svanessen29/Table-Top-Muon-Tomography/Figures/layout1.jpg

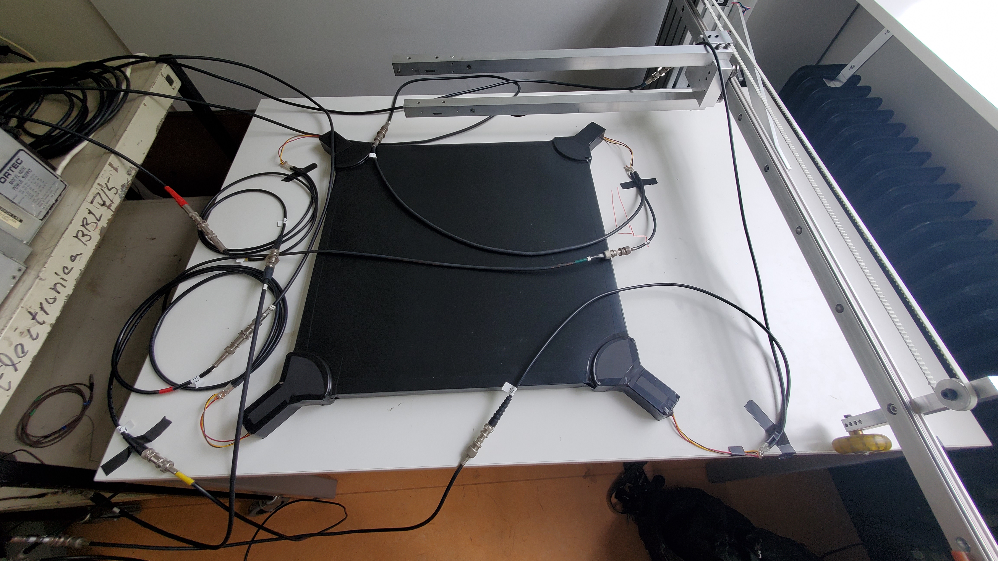
Figures/layout1.jpg
