svanessen29/Table-Top-Muon-Tomography/Figures/layout2.jpg

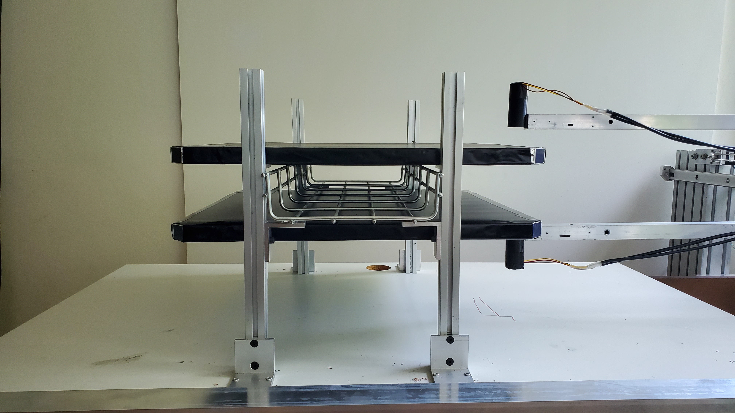
Figures/layout2.jpg
