svanessen29/Table-Top-Muon-Tomography/Software/scintillator_tape_spectra/tape_spectra_T2.png

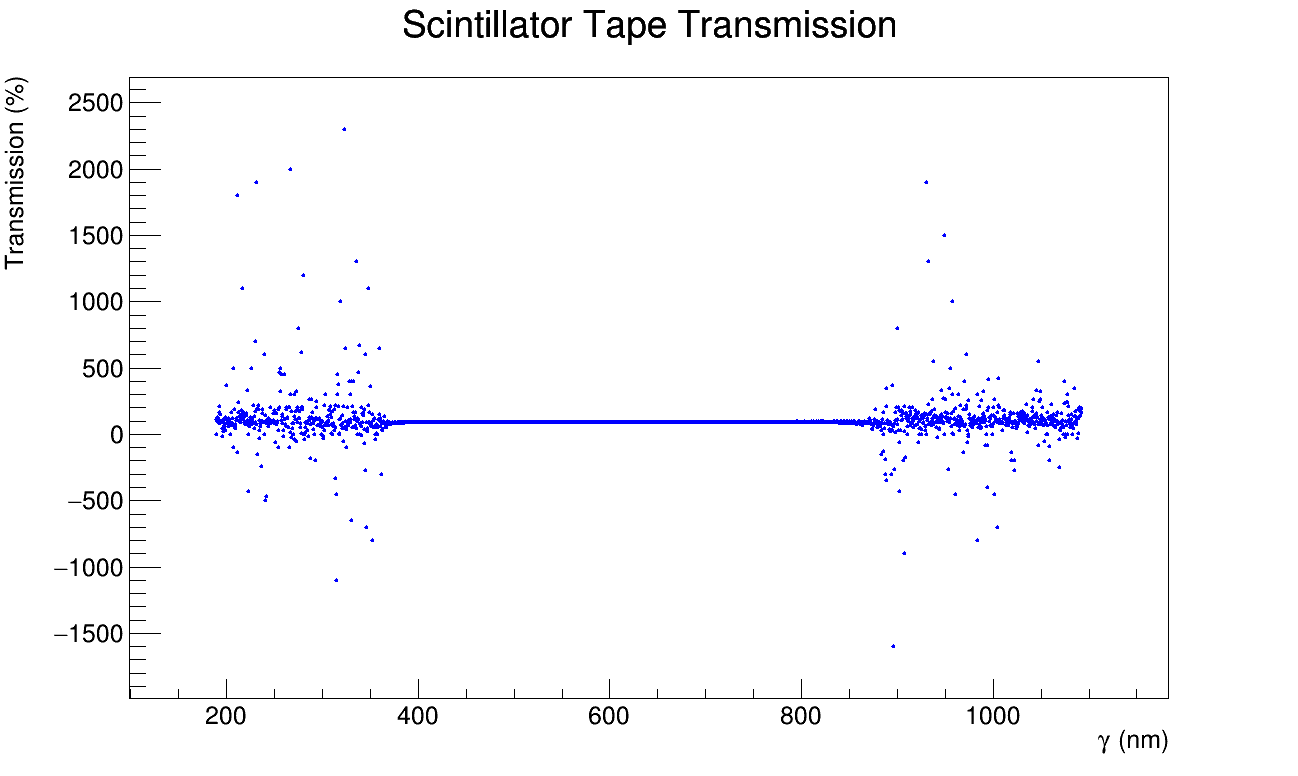
Software/scintillator_tape_spectra/tape_spectra_T2.png
