svanessen29/Table-Top-Muon-Tomography/Documents/BuildInstructions/README.md

# Build Instructions
This sections outlines the steps that were taken to fully construct the table-top muon scanner

## Sections
1. [Frame Assembly](FrameAssembly.md)
2. How to prepare the [scintillator](Scintillator.md)
3. How to prepare the [PMT](PMT.md)
4. How to connect all the [electronics](Electronics.md) together
