svanessen29/Table-Top-Muon-Tomography/Figures/setup_pmt2_a.jpg

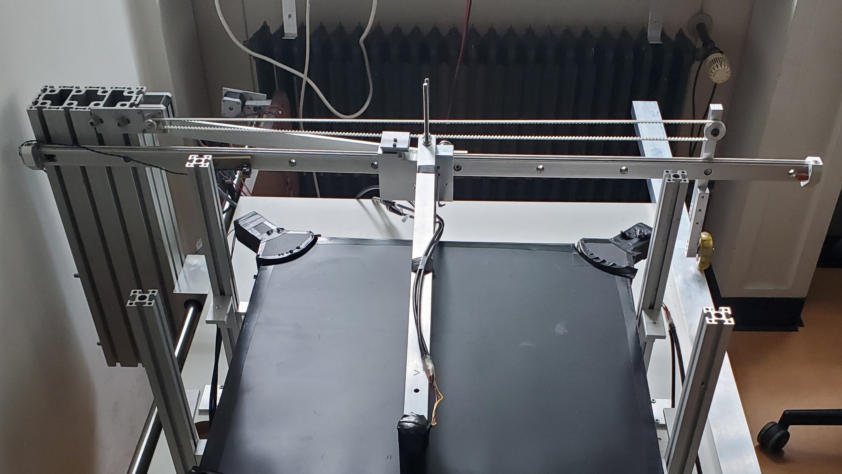
Figures/setup_pmt2_a.jpg
