svanessen29/Table-Top-Muon-Tomography/Figures/setup_pmt8.jpg

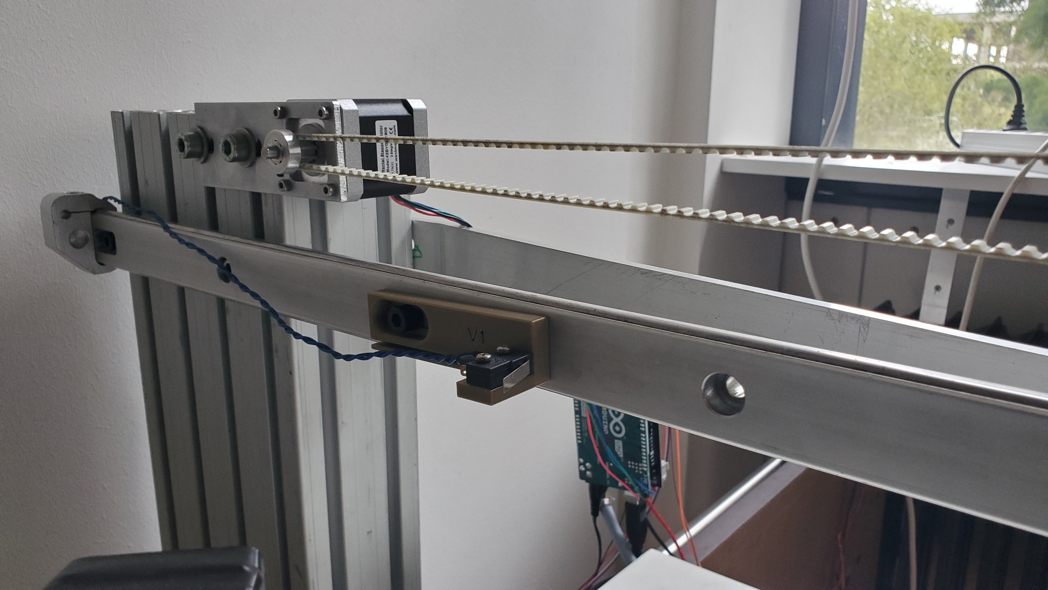
Figures/setup_pmt8.jpg
