svanessen29/Table-Top-Muon-Tomography/Results/PMT_graphs/PMT10_voltage.pdf

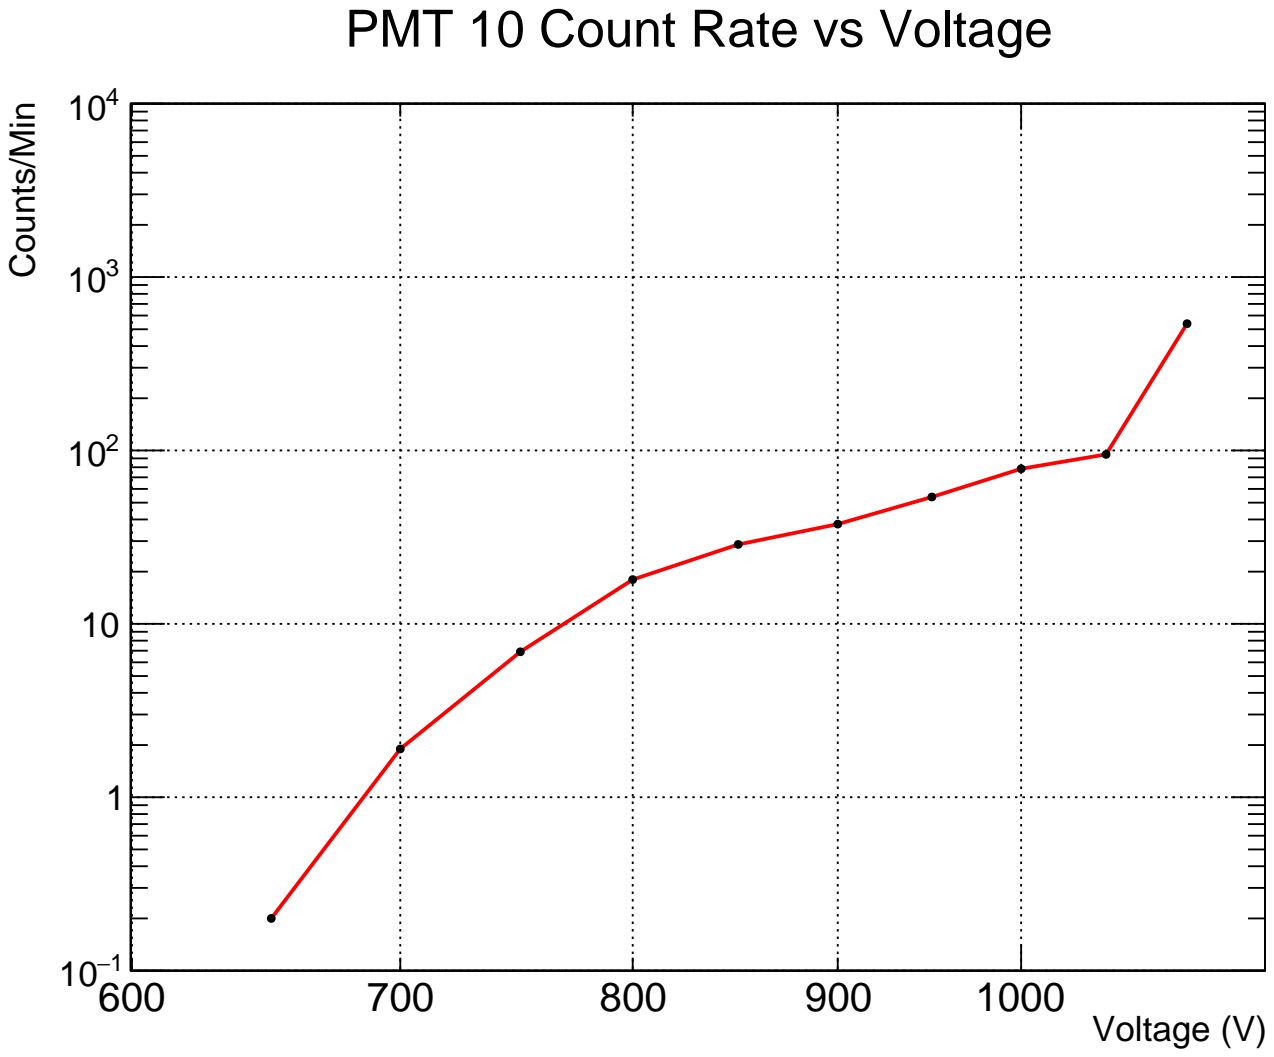
[picture p23: figure]
Voltage (V) ⁻¹ 10; Counts/Min; PMT 10 Count Rate vs Voltage
