svanessen29/Table-Top-Muon-Tomography/Results/PMT_graphs/PMT11_voltage.pdf

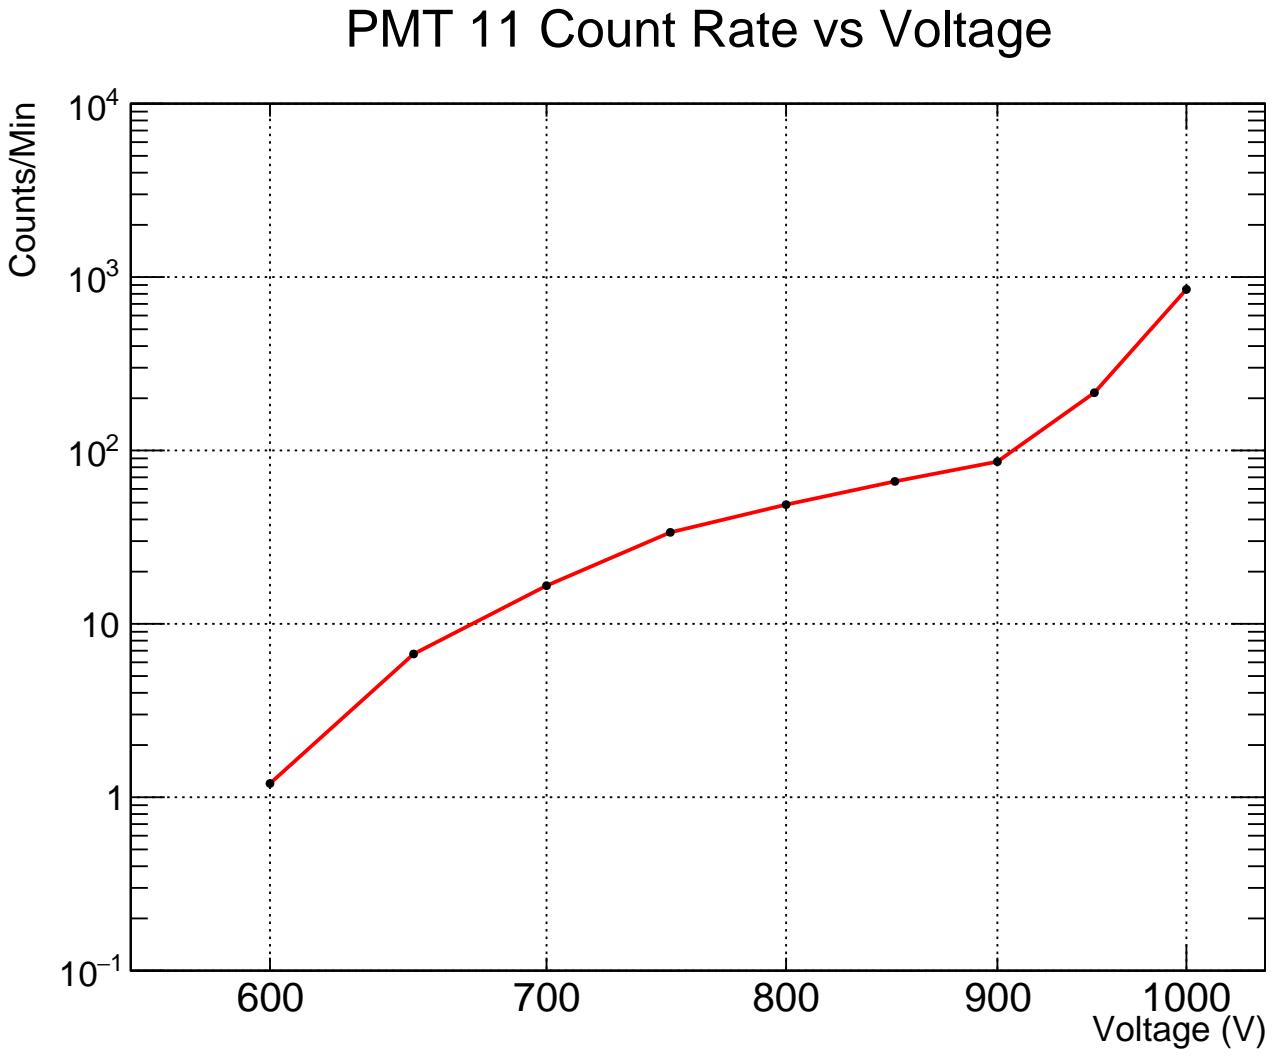
[picture p24: figure]
Voltage (V) ⁻¹ 10; Counts/Min; PMT 11 Count Rate vs Voltage
