svanessen29/Table-Top-Muon-Tomography/Results/PMT_graphs/PMT1_voltage.pdf

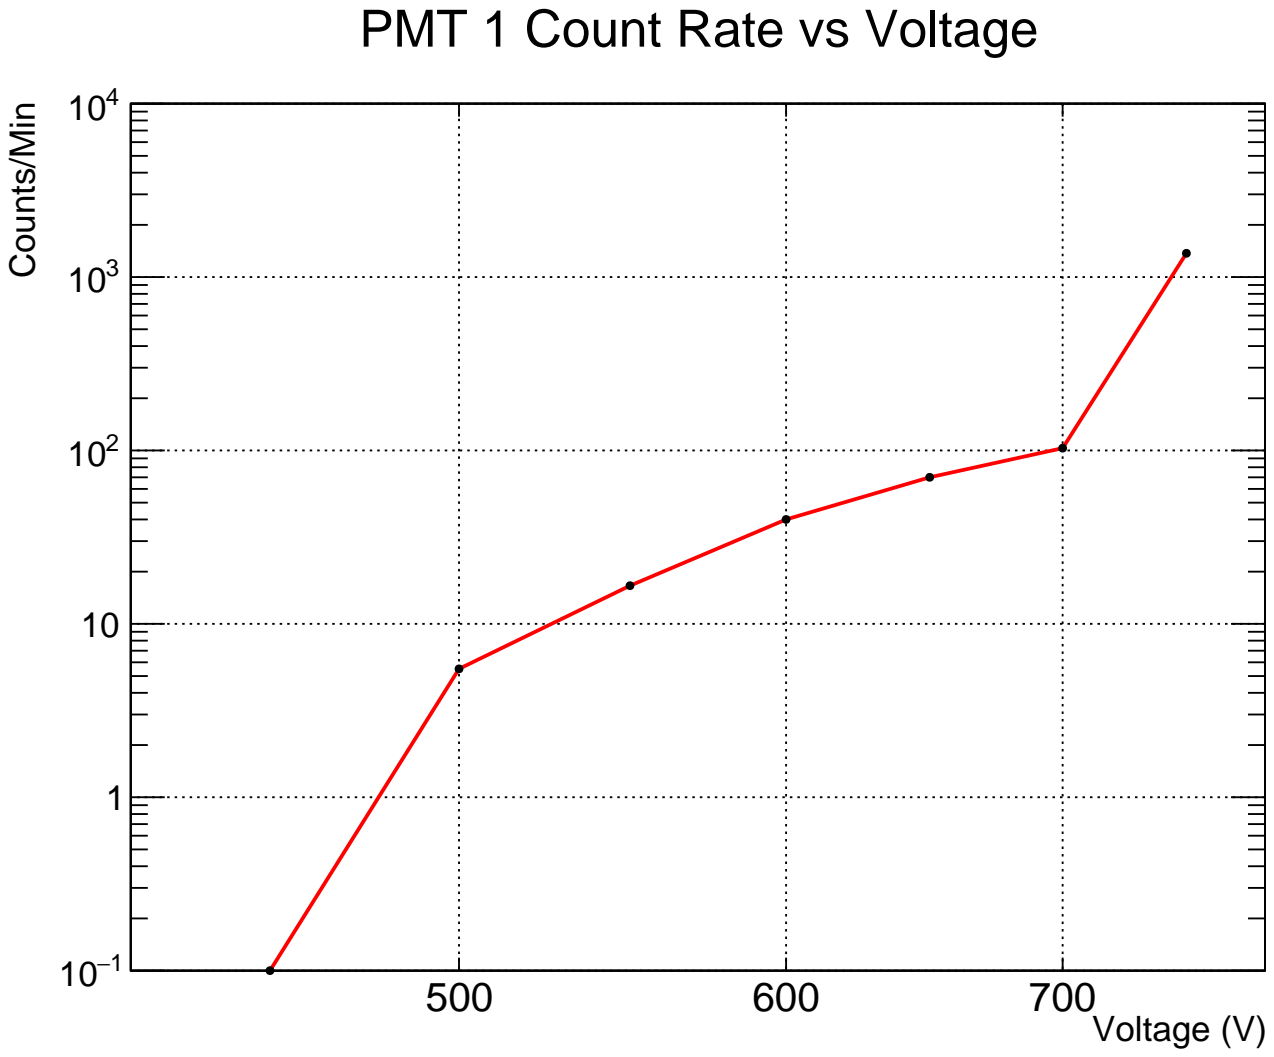
[picture p25: figure]
Voltage (V); Counts/Min; PMT 1 Count Rate vs Voltage
