svanessen29/Table-Top-Muon-Tomography/Results/PMT_graphs/PMT2_voltage.pdf

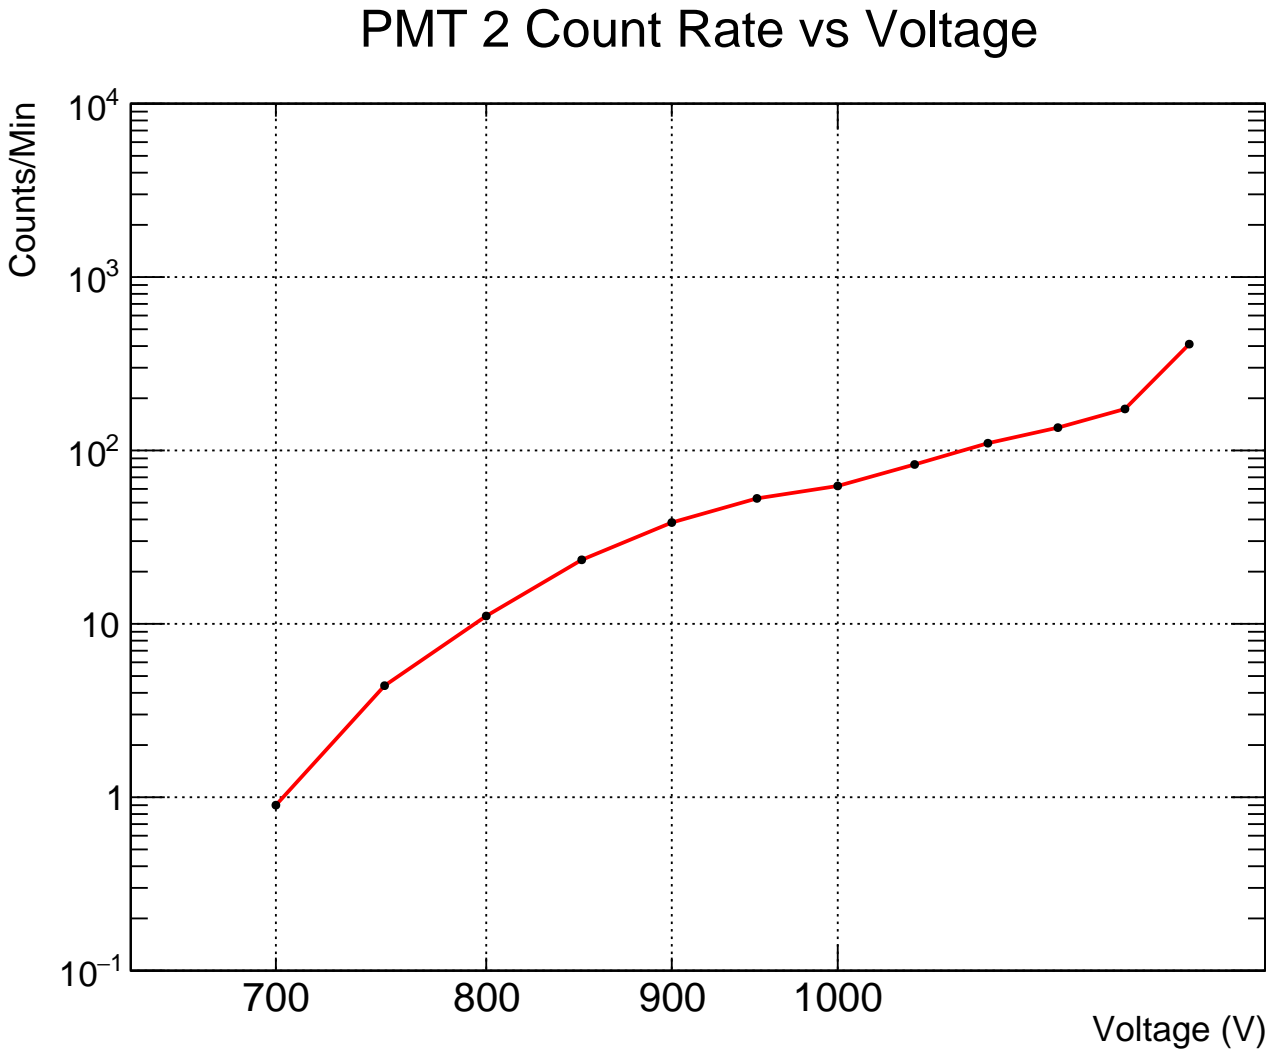
[picture p26: figure]
Voltage (V) ⁻¹ 10; Counts/Min; PMT 2 Count Rate vs Voltage
