svanessen29/Table-Top-Muon-Tomography/Results/PMT_graphs/PMT3_voltage.pdf

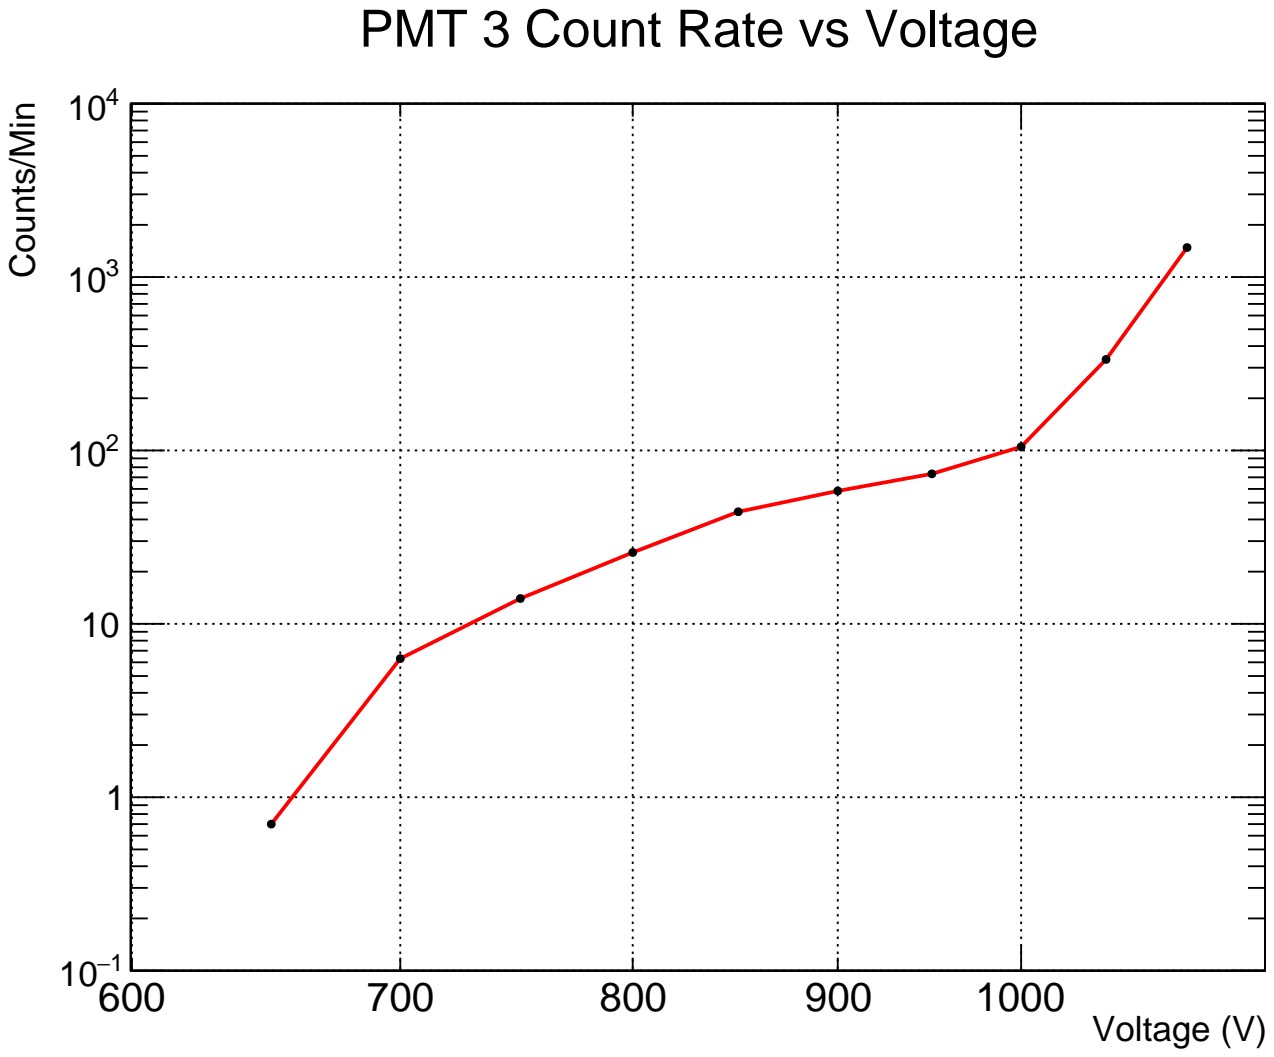
[picture p27: figure]
Voltage (V) ⁻¹ 10; Counts/Min; PMT 3 Count Rate vs Voltage
