svanessen29/Table-Top-Muon-Tomography/Results/PMT_graphs/PMT4_voltage.pdf

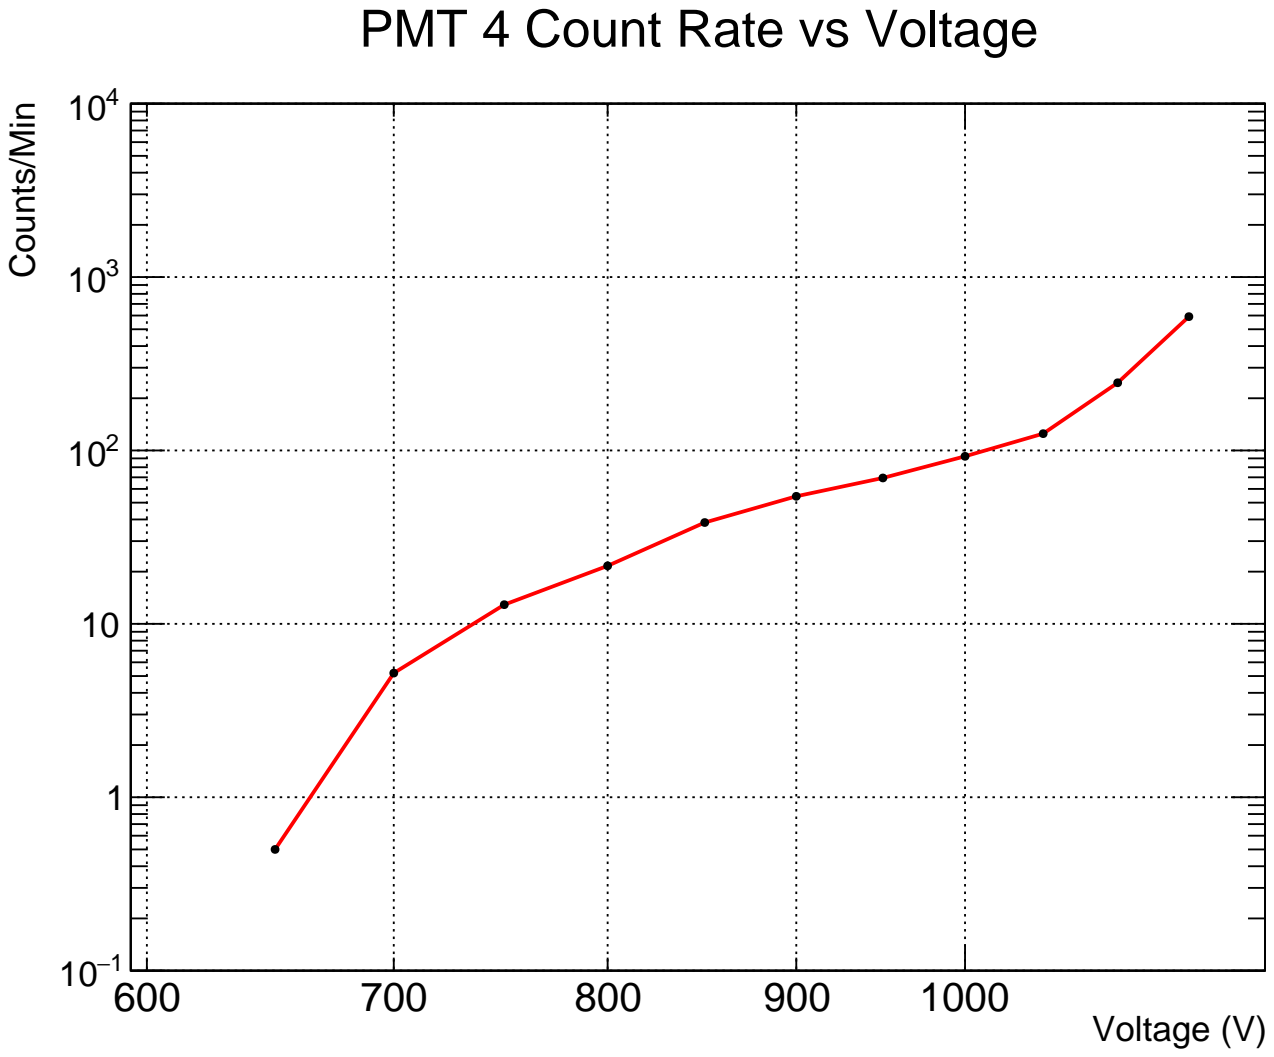
[picture p28: figure]
Voltage (V) ⁻¹ 10; Counts/Min; PMT 4 Count Rate vs Voltage
