svanessen29/Table-Top-Muon-Tomography/Results/PMT_graphs/PMT5_voltage.pdf

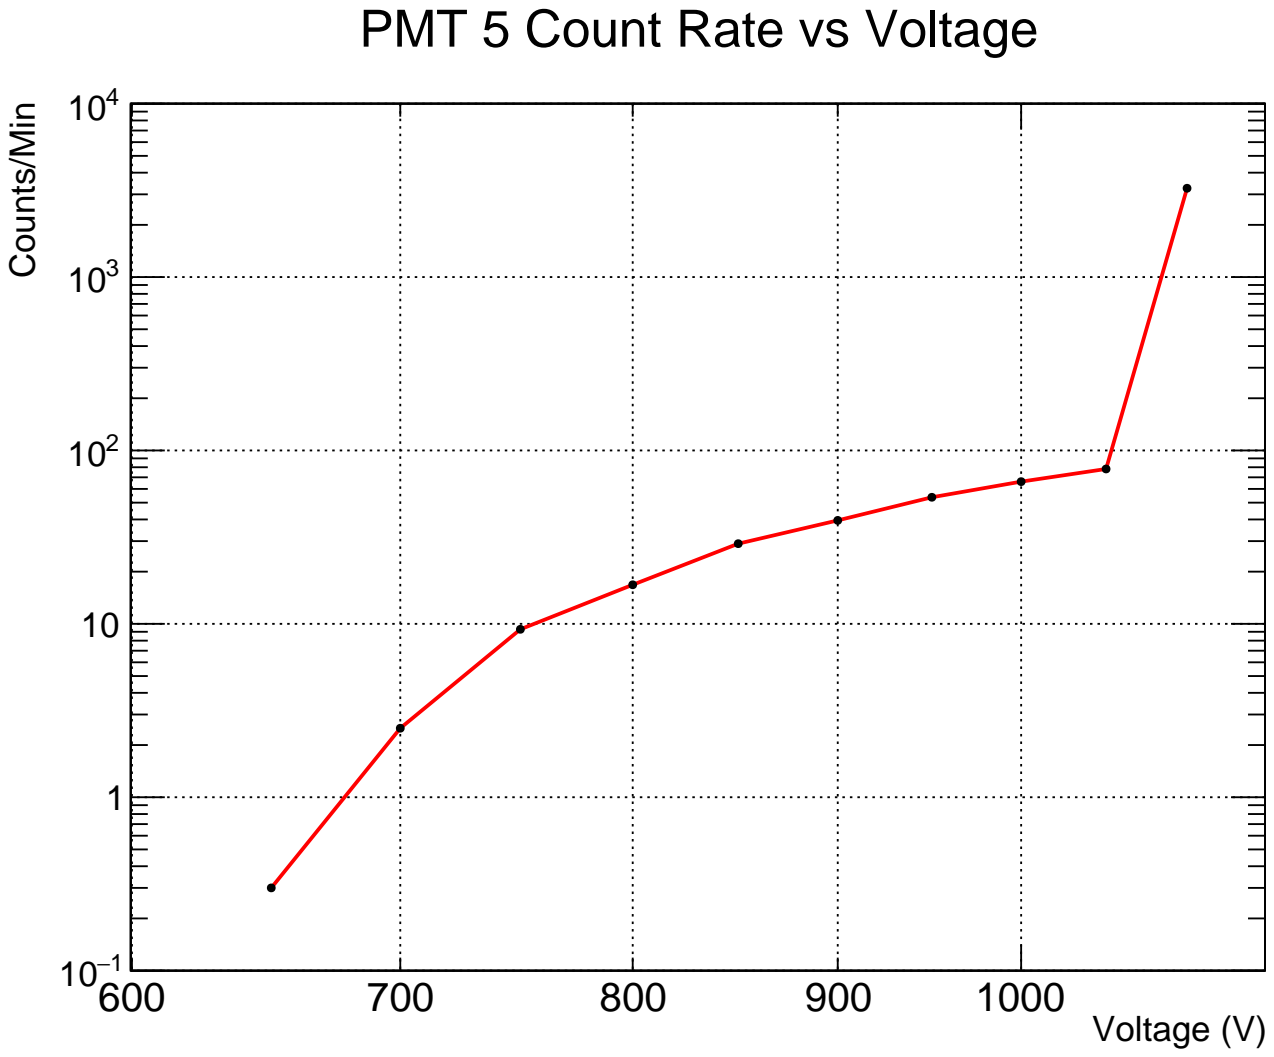
[picture p29: figure]
Voltage (V) ⁻¹ 10; Counts/Min; PMT 5 Count Rate vs Voltage
