svanessen29/Table-Top-Muon-Tomography/Results/PMT_graphs/PMT6_voltage.pdf

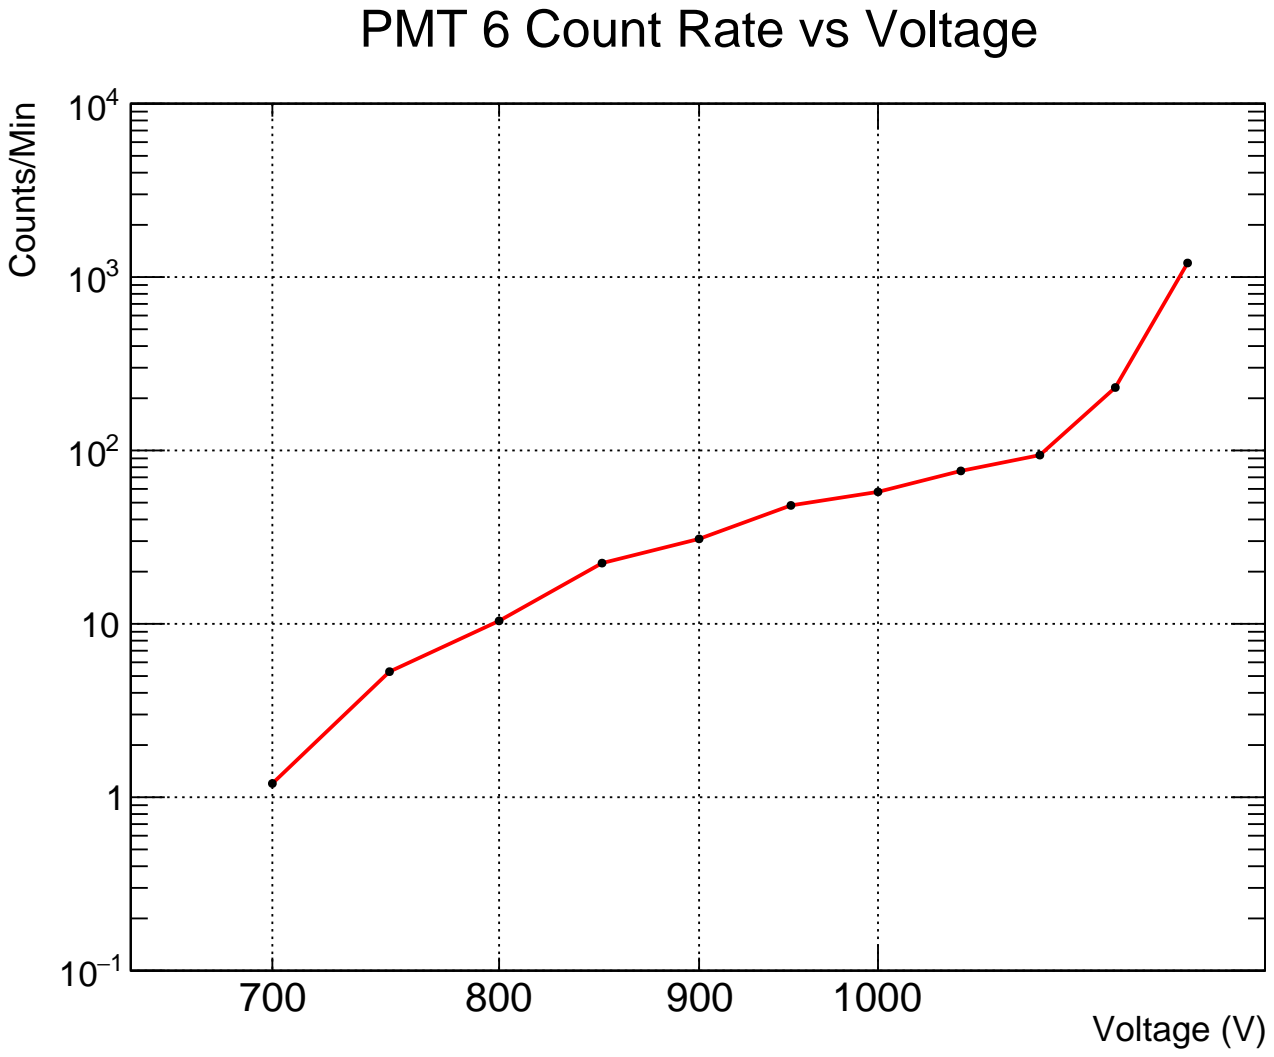
[picture p30: figure]
Voltage (V) ⁻¹ 10; Counts/Min; PMT 6 Count Rate vs Voltage
