svanessen29/Table-Top-Muon-Tomography/Results/PMT_graphs/PMT7_voltage.pdf

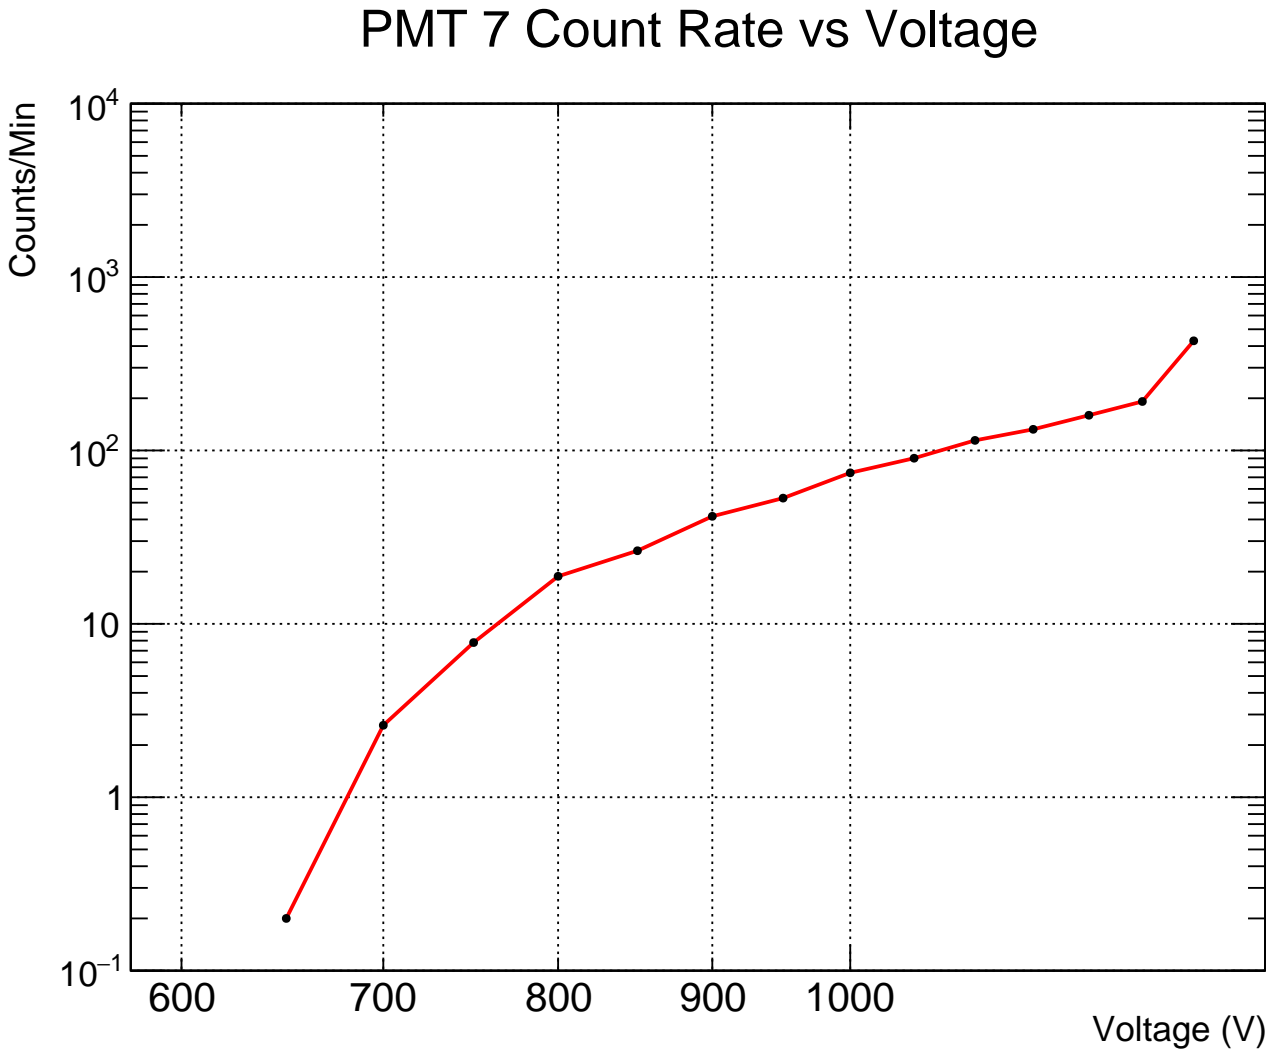
[picture p31: figure]
Voltage (V) ⁻¹ 10; Counts/Min; PMT 7 Count Rate vs Voltage
