svanessen29/Table-Top-Muon-Tomography/Results/PMT_graphs/PMT8_voltage.pdf

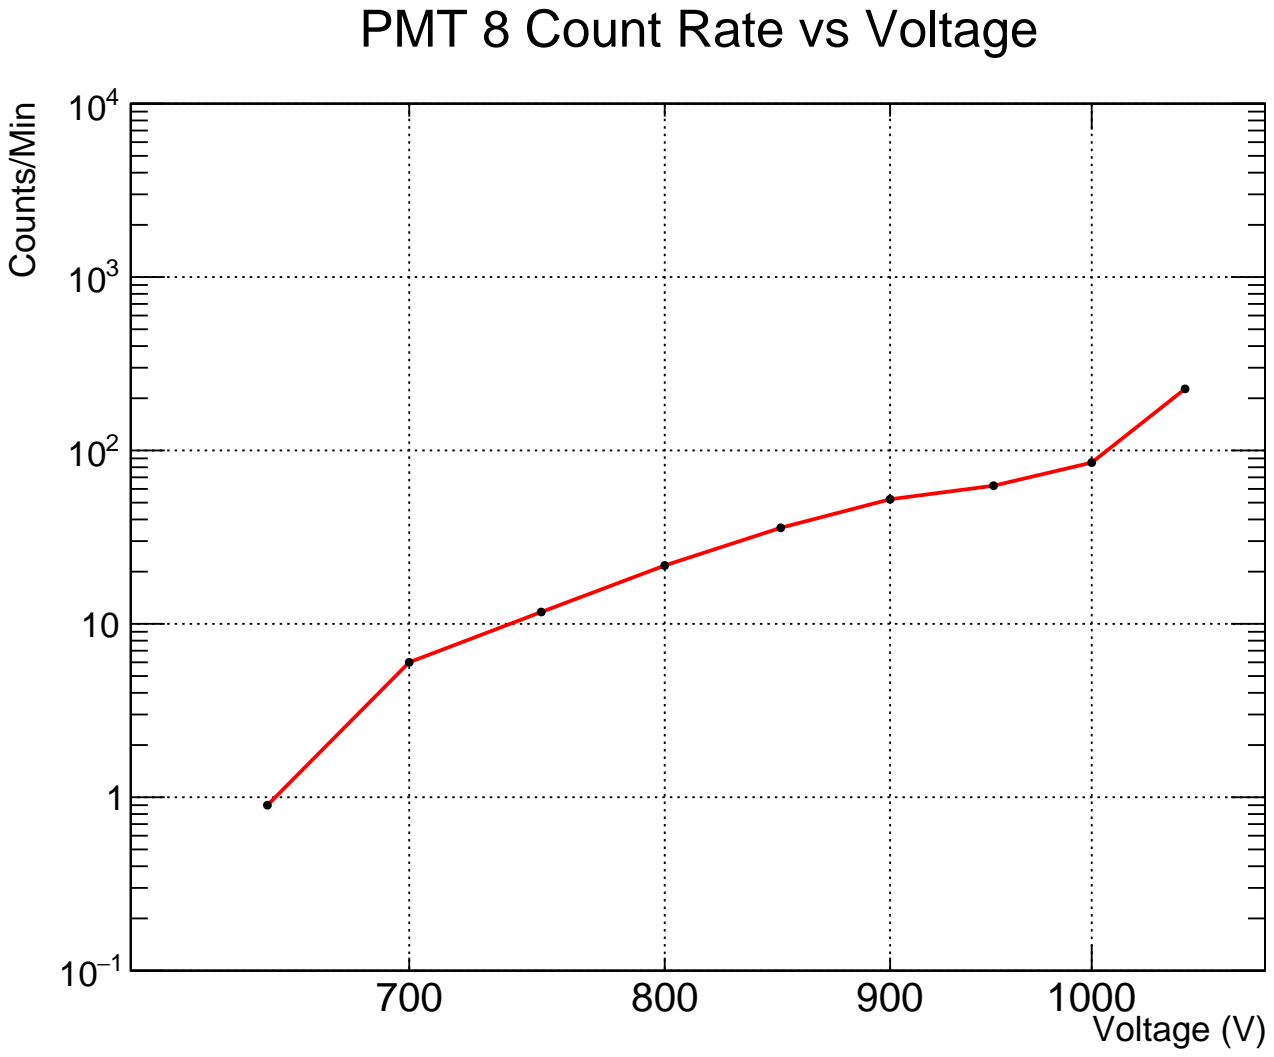
[picture p32: figure]
Voltage (V); Counts/Min; PMT 8 Count Rate vs Voltage
