svanessen29/Table-Top-Muon-Tomography/Results/PMT_graphs/PMT9_voltage.pdf

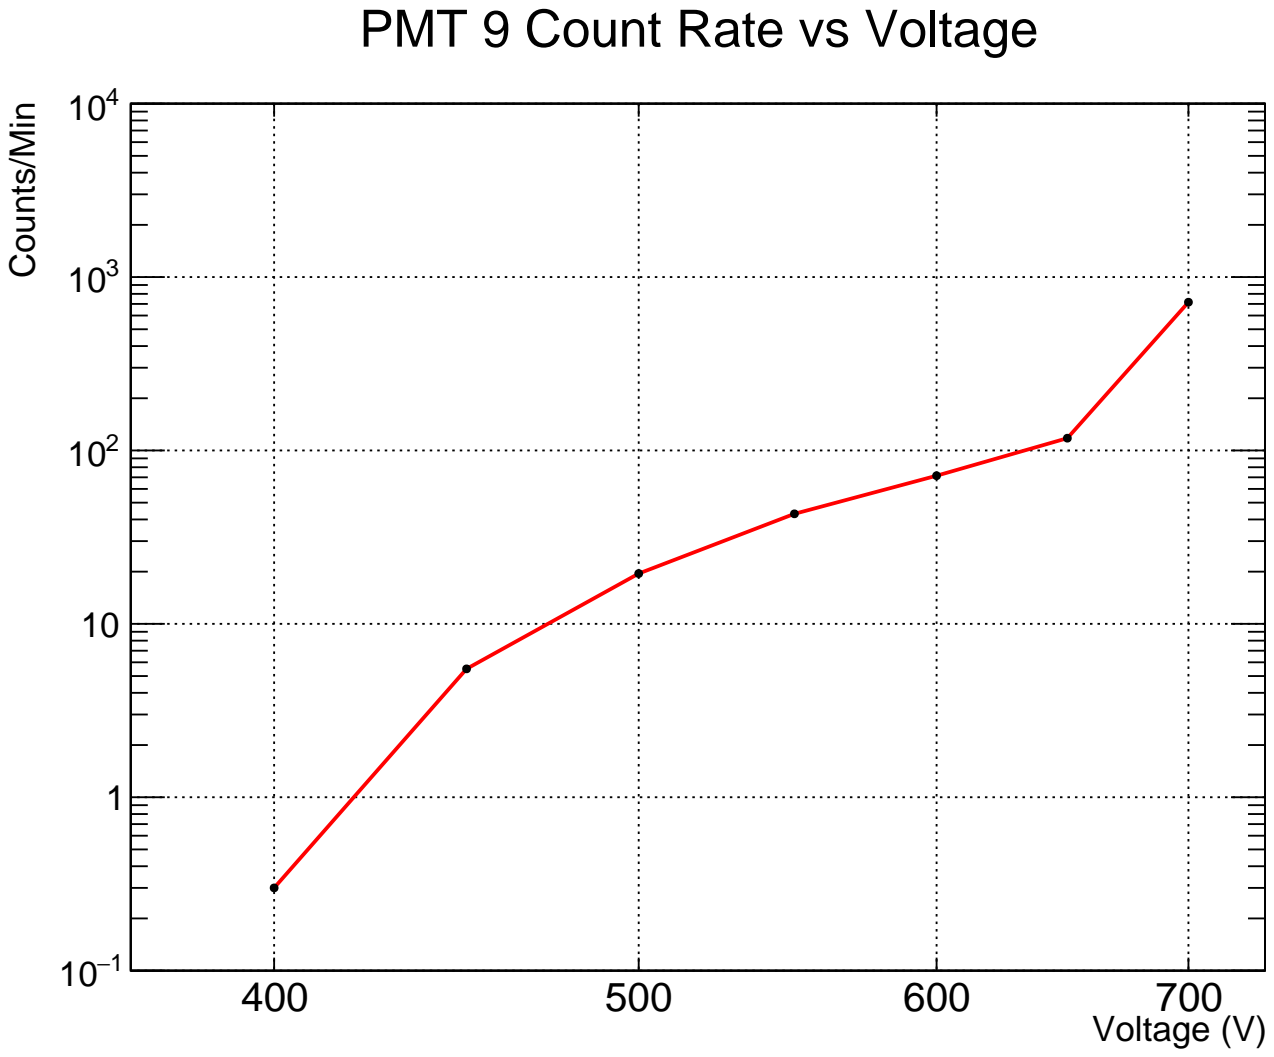
[picture p33: figure]
Voltage (V) ⁻¹ 10; Counts/Min; PMT 9 Count Rate vs Voltage
