svanessen29/Table-Top-Muon-Tomography/Results/PMT_graphs/PMT_Calibration_8.pdf

650 | 700 | 750 | 800 | 850 | 900 | 950 | 1000 | 1050
Voltage (V)

0.1

1

10

100

1000

Counts/Min

## PMT 8 Count Rate vs Voltage

Lower Limit | | Upper Limit
| Optimum Region
