svanessen29/Table-Top-Muon-Tomography/Results/PMT_graphs/PMT_Calibration_Multiple.pdf

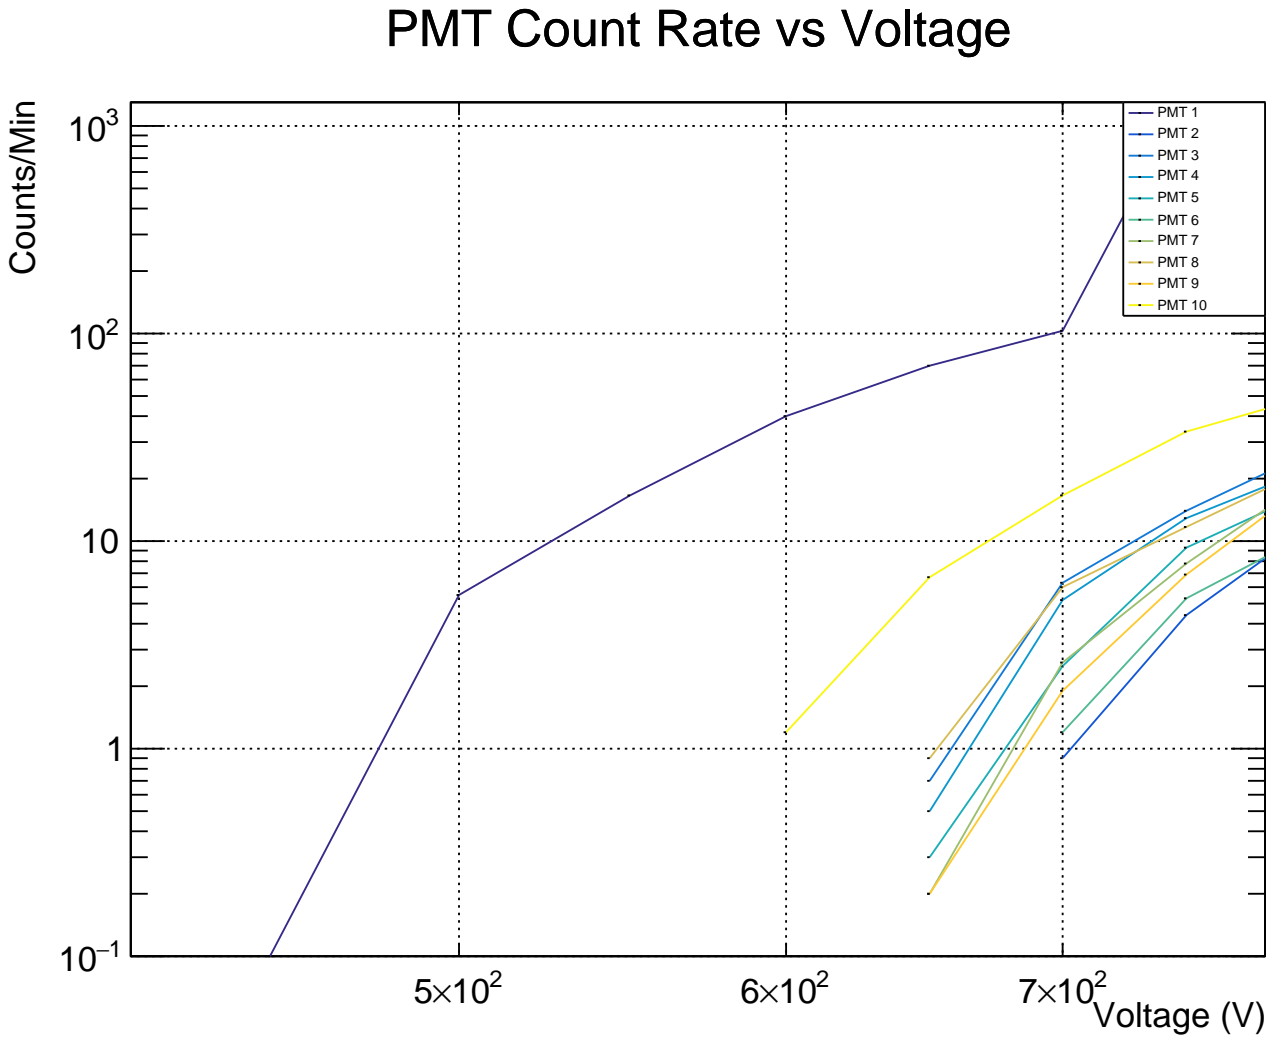
[picture p34: figure]
×10Voltage (V); Counts/Min; PMT Count Rate vs Voltage; PMT 1

PMT 2 PMT 3 PMT 4 PMT 5 PMT 6 PMT 7 PMT 8 PMT 9 PMT 10
