svanessen29/Table-Top-Muon-Tomography/Results/PMT_graphs/PMT_Calibration_Multiple2.pdf

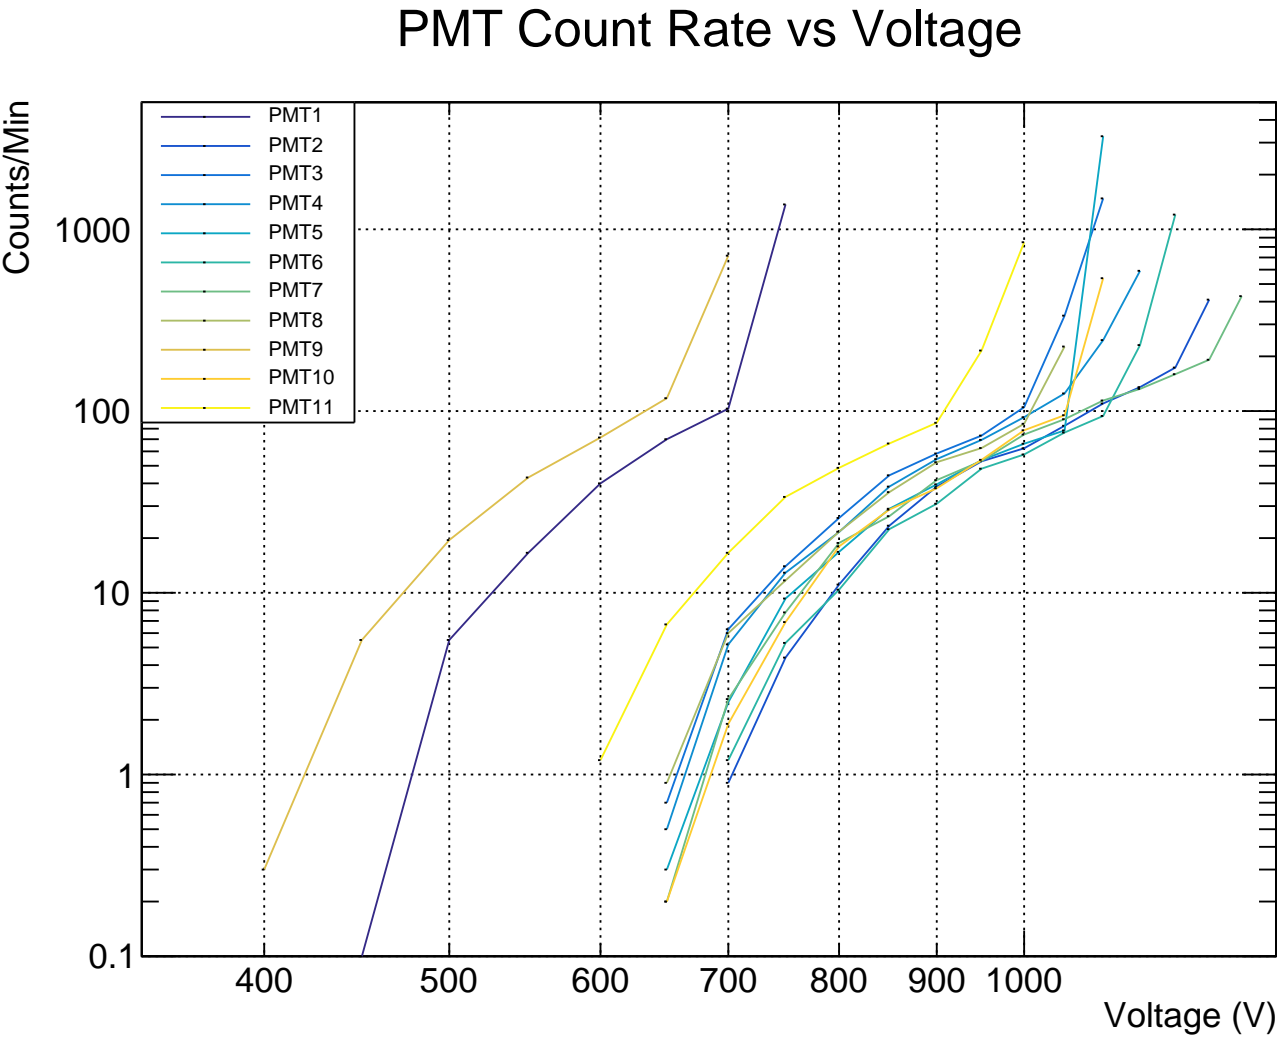
[picture p35: figure]
Voltage (V); Counts/Min; PMT Count Rate vs Voltage; PMT1 PMT2 PMT3 PMT4 PMT5; PMT6 PMT7 PMT8 PMT9 PMT10 PMT11
