svanessen29/Table-Top-Muon-Tomography/Results/PMT_graphs/PMT2_voltage.png

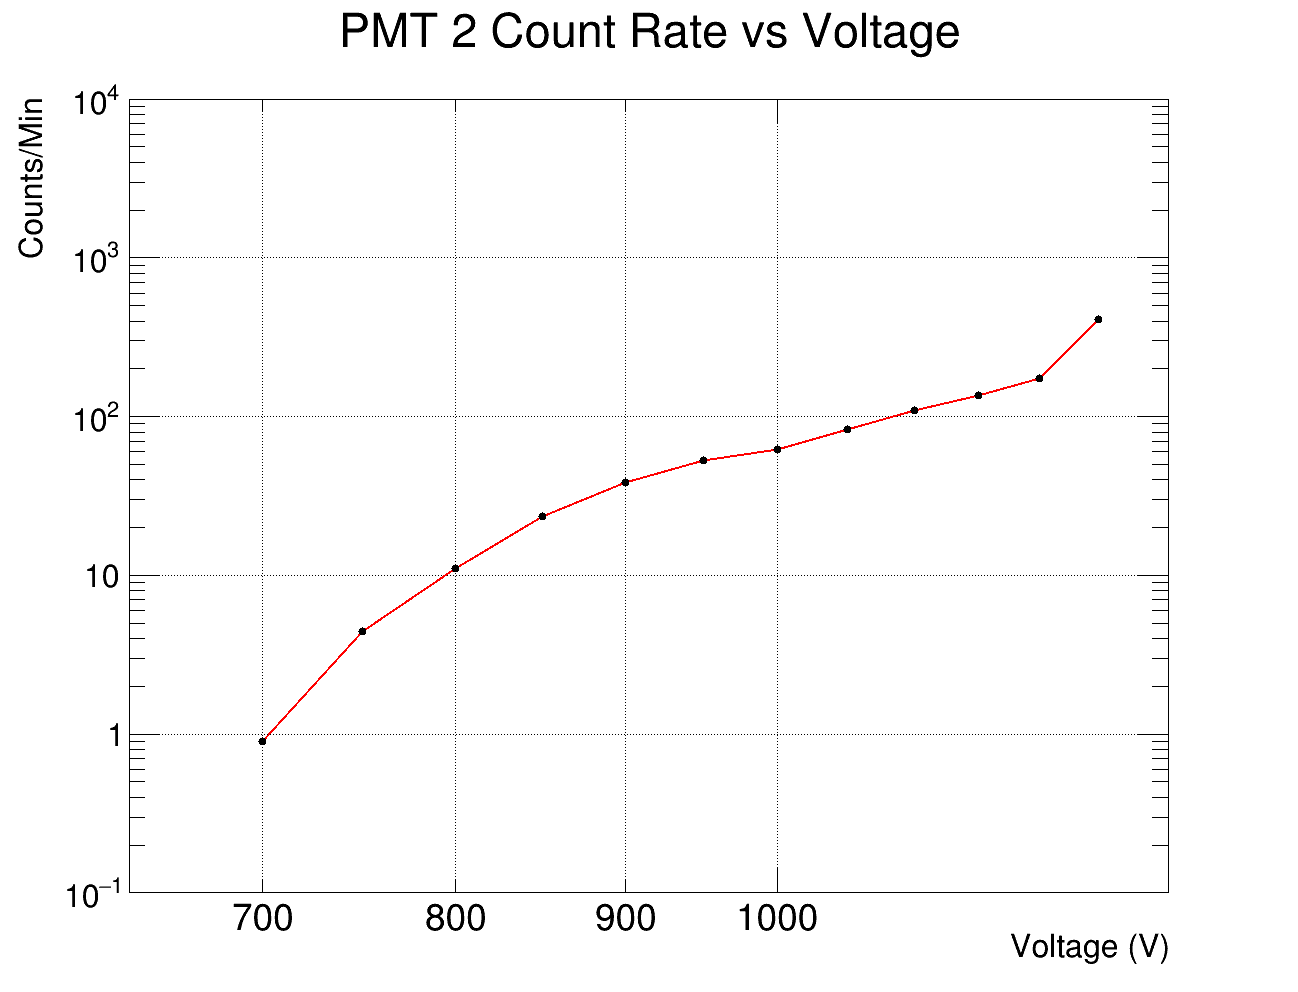
Results/PMT_graphs/PMT2_voltage.png
