svanessen29/Table-Top-Muon-Tomography/Results/PMT_graphs/PMT7_voltage.png

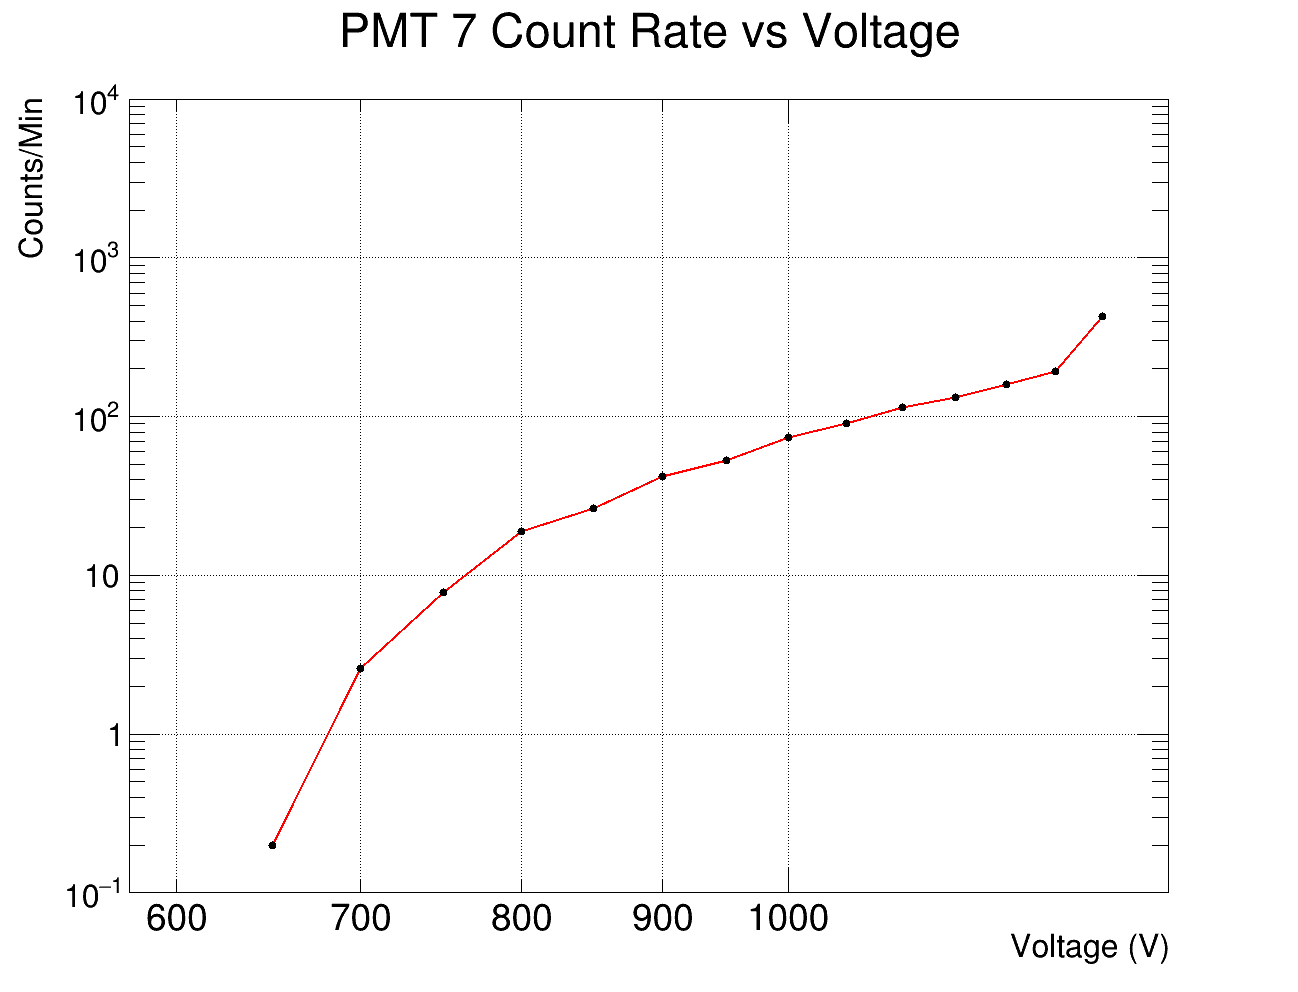
Results/PMT_graphs/PMT7_voltage.png
