svanessen29/Table-Top-Muon-Tomography/Results/PMT_graphs/PMT8_voltage.png

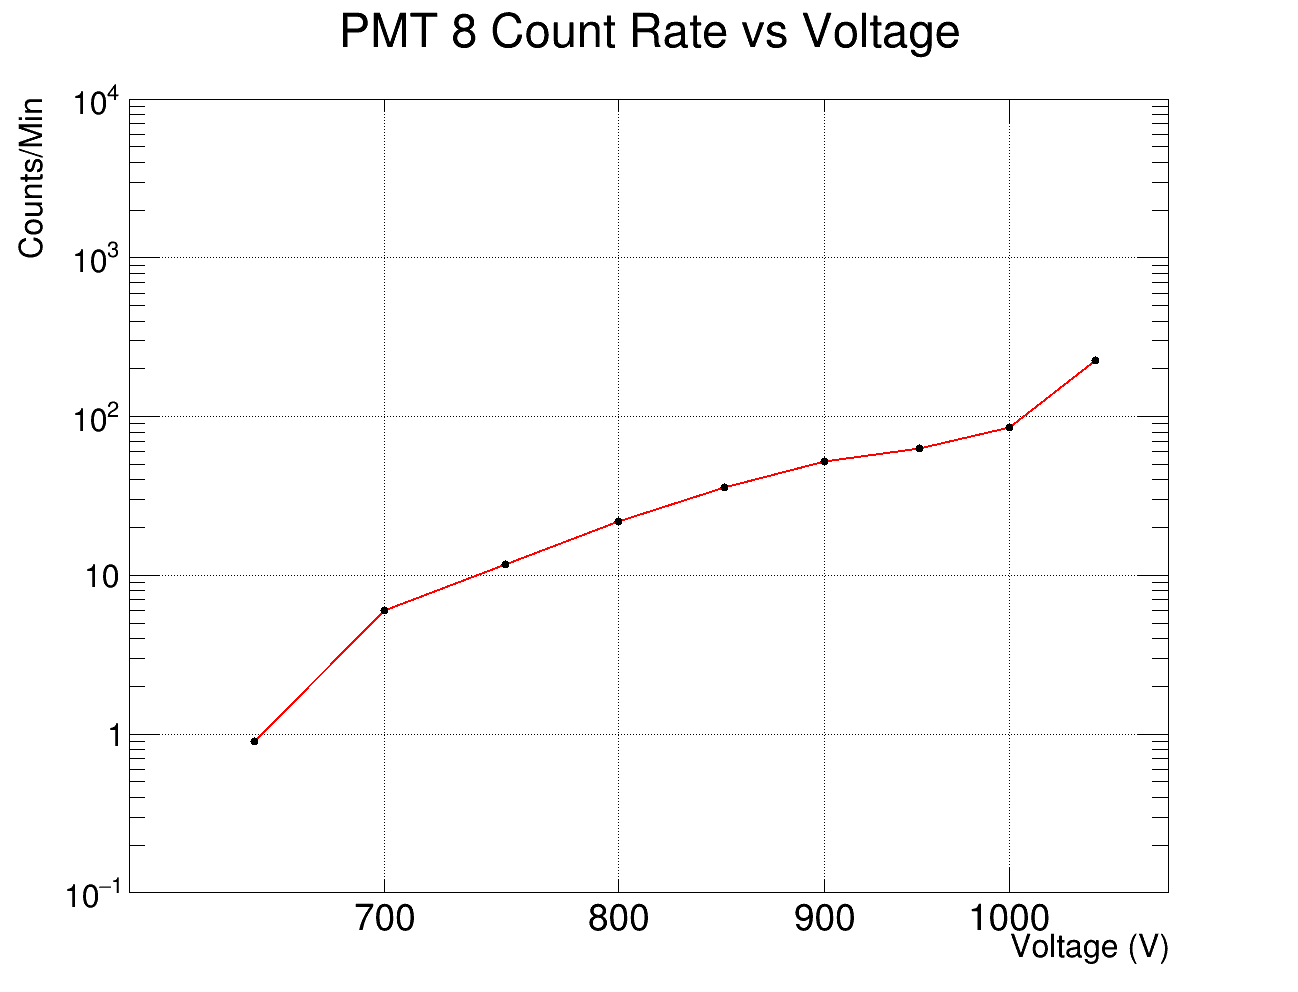
Results/PMT_graphs/PMT8_voltage.png
