svanessen29/Table-Top-Muon-Tomography/Results/PMT_graphs/PMT11_voltage.png

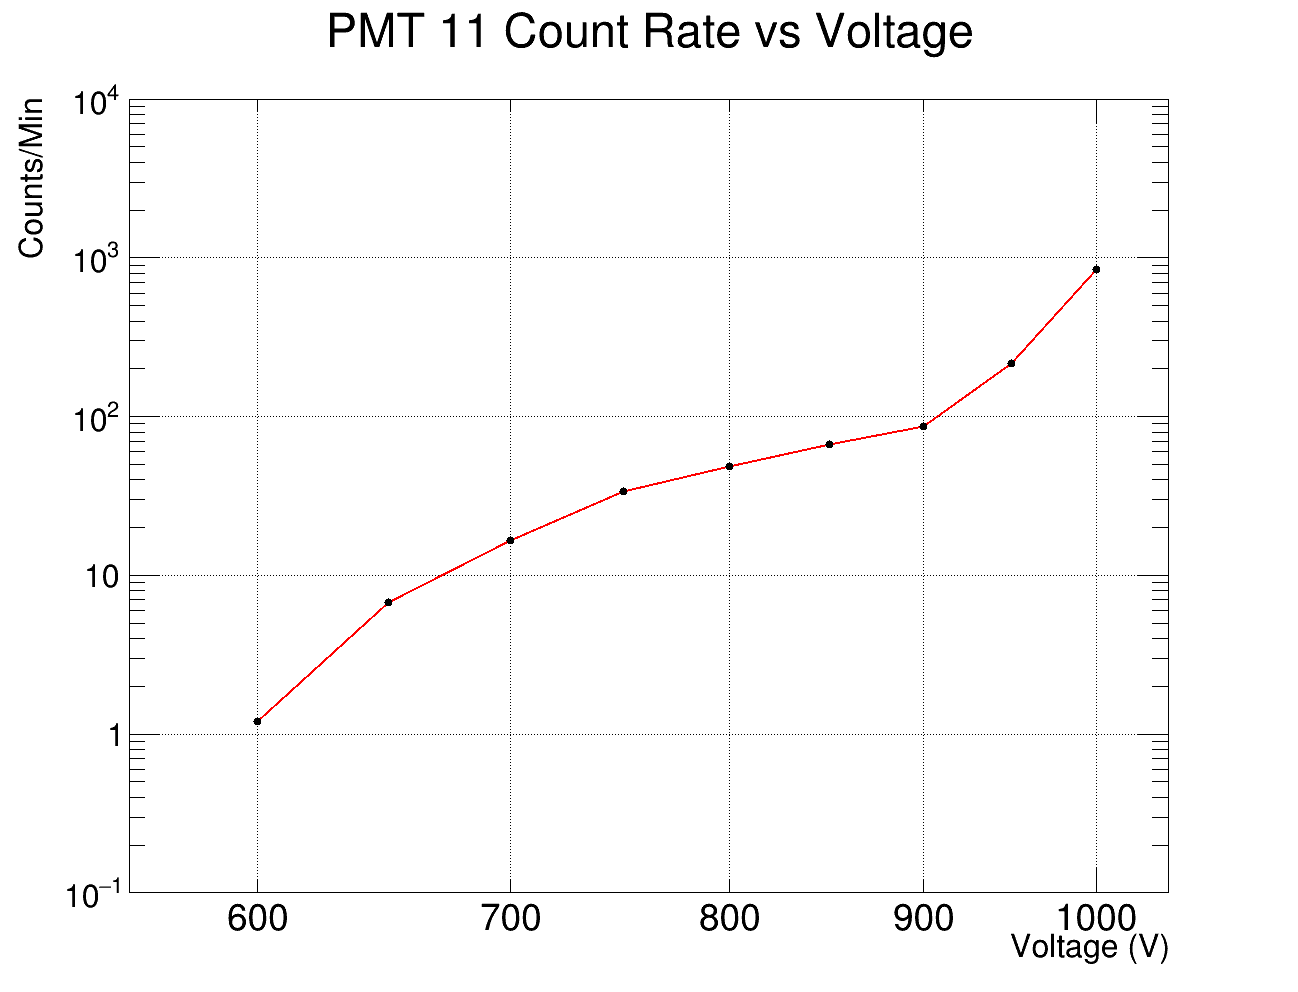
Results/PMT_graphs/PMT11_voltage.png
