svanessen29/Table-Top-Muon-Tomography/Results/PMT_graphs/PMT_Calibration_8.png

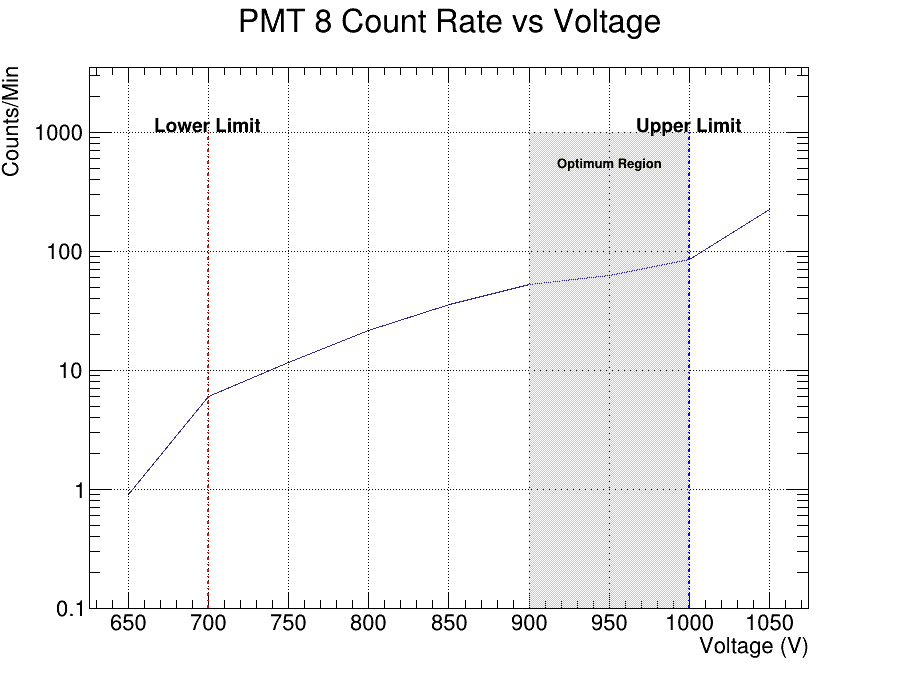
Results/PMT_graphs/PMT_Calibration_8.png
