svanessen29/Table-Top-Muon-Tomography/Results/PMT_graphs/PMT_Calibration_Multiple3.png

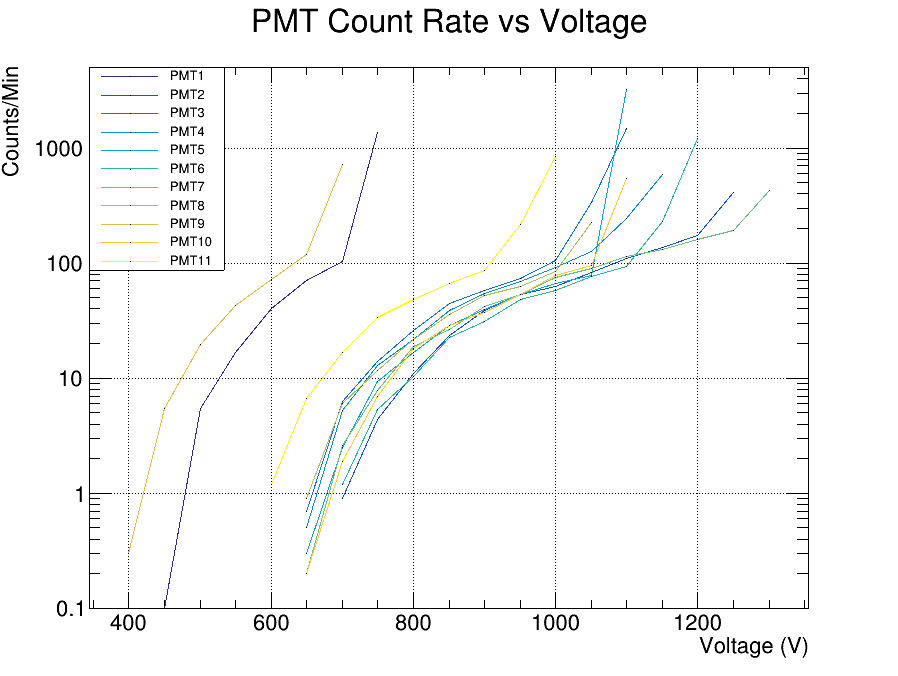
Results/PMT_graphs/PMT_Calibration_Multiple3.png
