svanessen29/Table-Top-Muon-Tomography/Software/scintillator_tape_spectra/tape_spectra_A1.pdf

## Scintillator Tape Absorbance

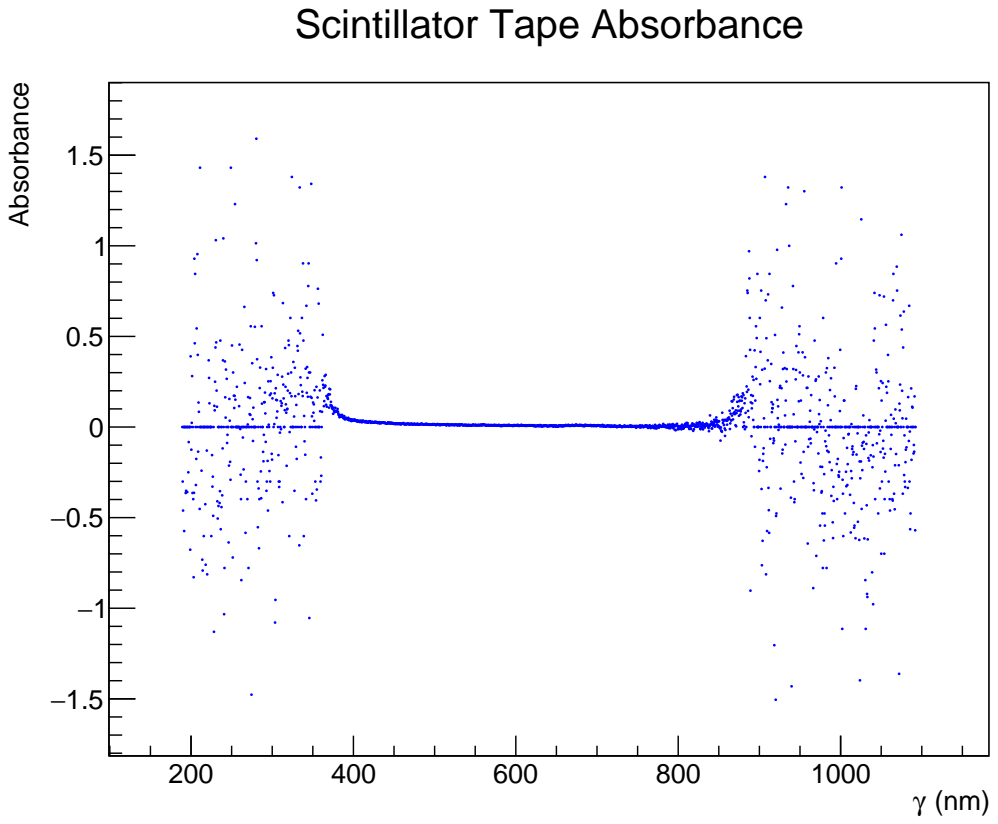
[picture p48: page 1]
Absorbance
