svanessen29/Table-Top-Muon-Tomography/Software/scintillator_tape_spectra/tape_spectra_A2.pdf

## Scintillator Tape Absorbance

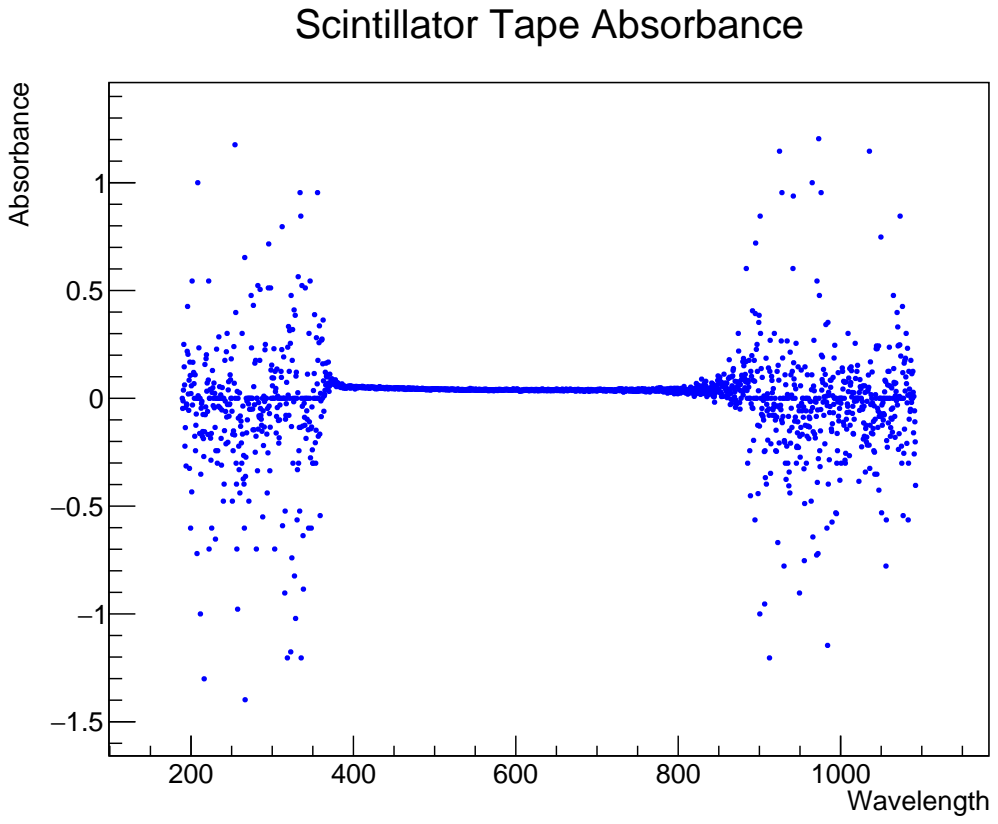
[picture p49: page 1]
Wavelength −1.5−1 −0.5; Absorbance
