svanessen29/Table-Top-Muon-Tomography/Software/scintillator_tape_spectra/tape_spectra_T1.pdf

## Scintillator Tape Transmission

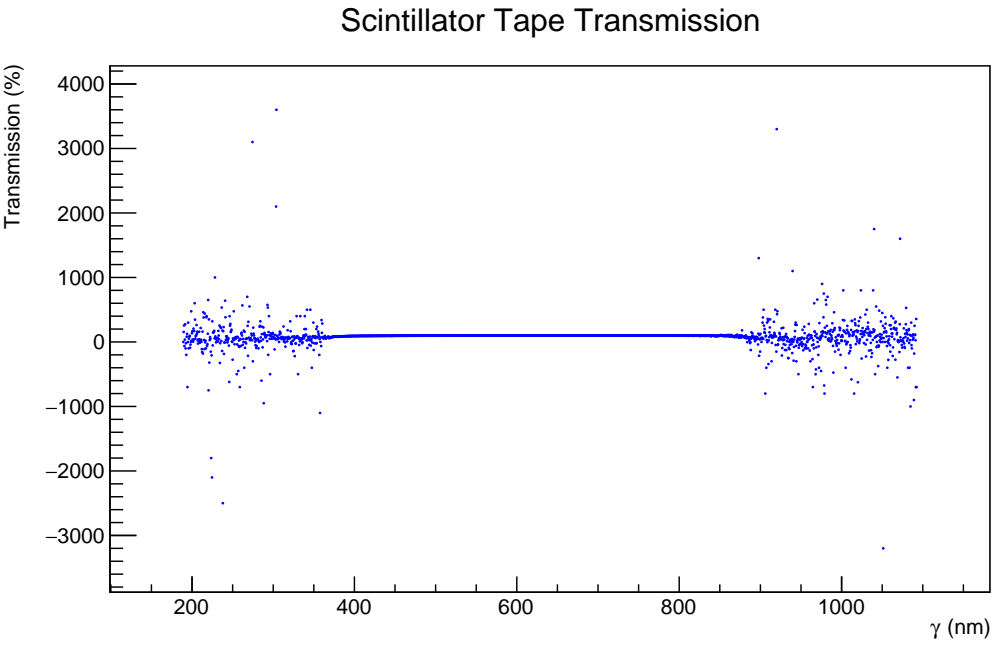
[picture p50: page 1]
Transmission (%)
