svanessen29/Table-Top-Muon-Tomography/Software/scintillator_tape_spectra/tape_spectra_T2.pdf

## Scintillator Tape Transmission

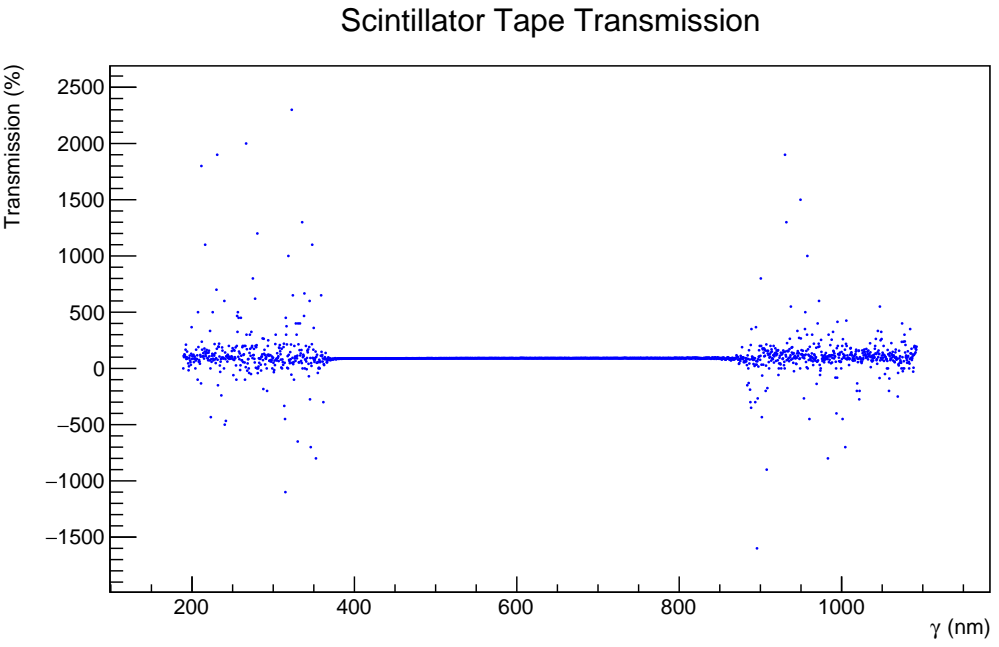
[picture p51: page 1]
Transmission (%)
