svanessen29/Table-Top-Muon-Tomography/(commit log)

2024-10-18 Arduino Linescan Code
2024-10-18 Update FrameAssembly.md
    Add image
2024-10-18 added photo of how scanner mounted to the table
2024-10-18 Update FrameAssembly.md
    Building out the body of the frame assembly
2024-10-18 Update FrameAssembly.md
    Further added to the body of the frame assembly
2024-10-18 PMT Voltage Graphs
2024-11-26 pmt wiring diagram
2024-11-26 pmt wiring to cable image
2024-11-26 wiring diagram
2024-11-26 jpg of wiring of system
2024-11-26 Update Electronics.md
    added wiring diagram
